BTIBR/Projeto-Eletronico/Documentos/Imagens/PS2 Controller.jpg

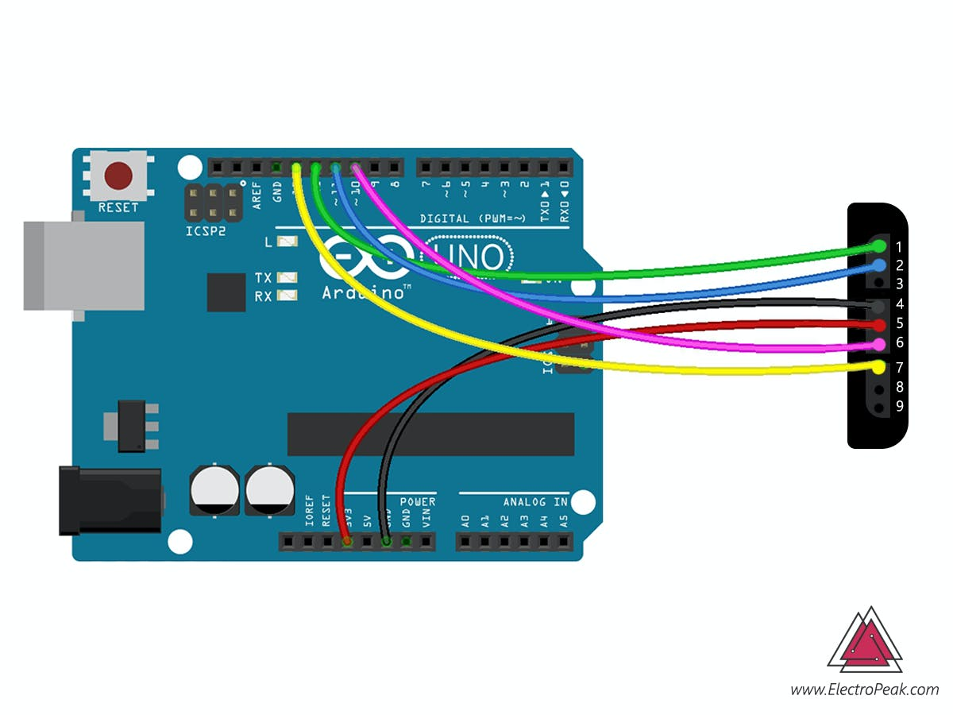
Documentos/Imagens/PS2 Controller.jpg
