BTIBR/Projeto-Eletronico/README.md

# Projeto-Eletronico

Projeto Eletrônico da PCI que contém o driver de controle dos motores de passo do Braço Robótico Leticya

### Software
- KiCad v5.1.9+
