BTIBR/Projeto-Eletronico/Datasheets/LM2596 - Buck DC-DC.PNG

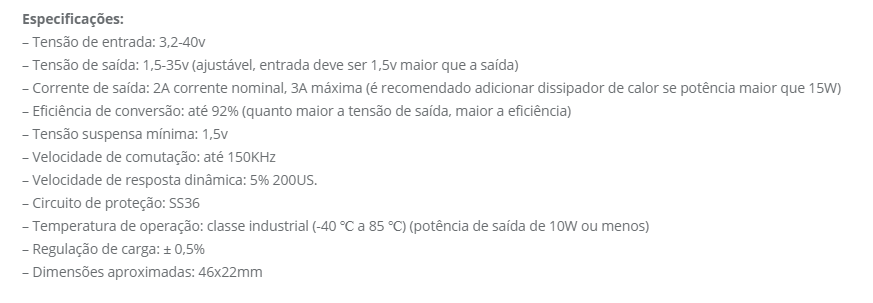
Datasheets/LM2596 - Buck DC-DC.PNG
