BTIBR/Projeto-Eletronico/Documentos/Imagens/Cabo RS485 CLP.png

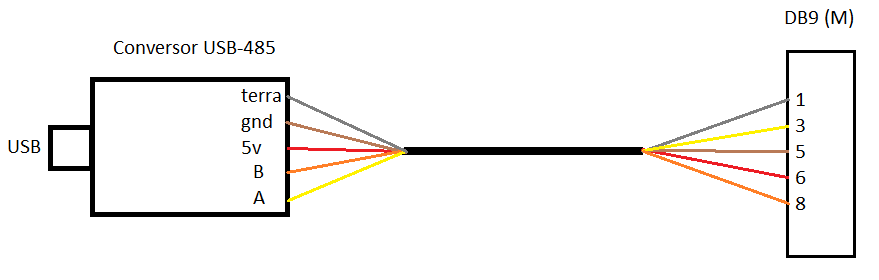
Documentos/Imagens/Cabo RS485 CLP.png
