BTIBR/Projeto-Eletronico/Documentos/Imagens/Layout PCB.png

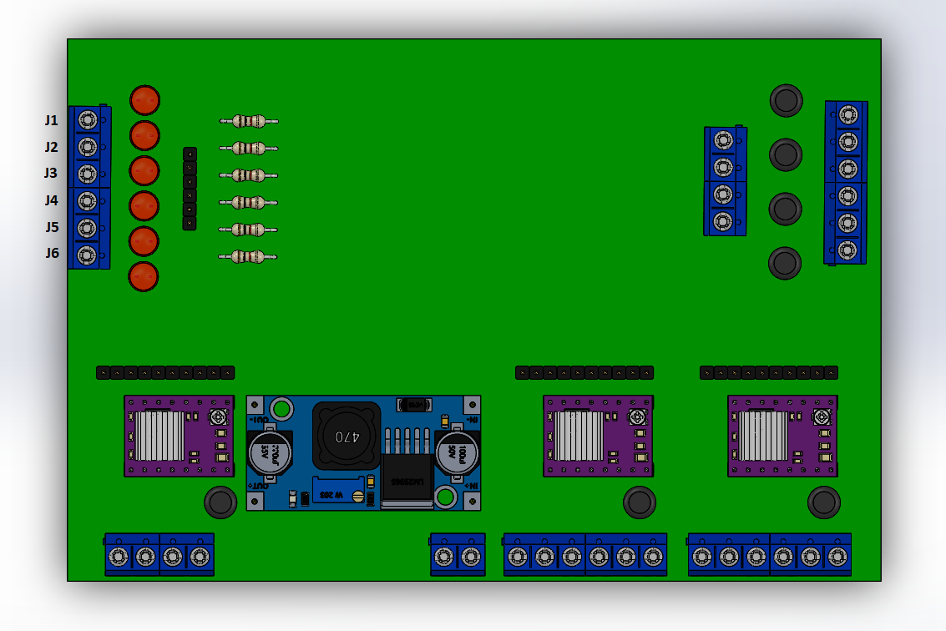
Documentos/Imagens/Layout PCB.png
