BTIBR/Projeto-Eletronico/Documentos/Imagens/Layout trilhas.png

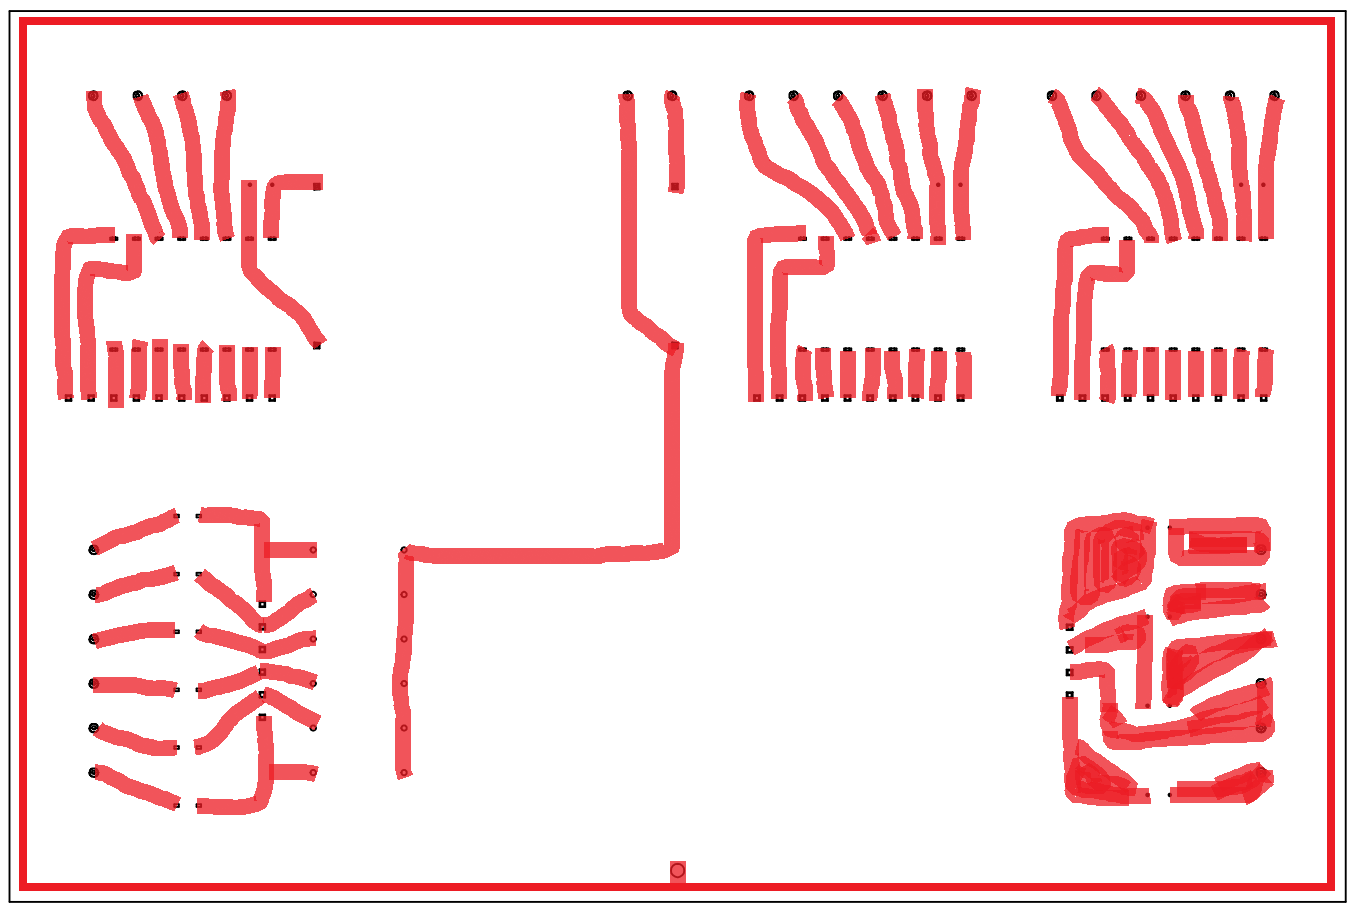
Documentos/Imagens/Layout trilhas.png
