BTIBR/Projeto-Eletronico/Documentos/Imagens/lm331 example.png

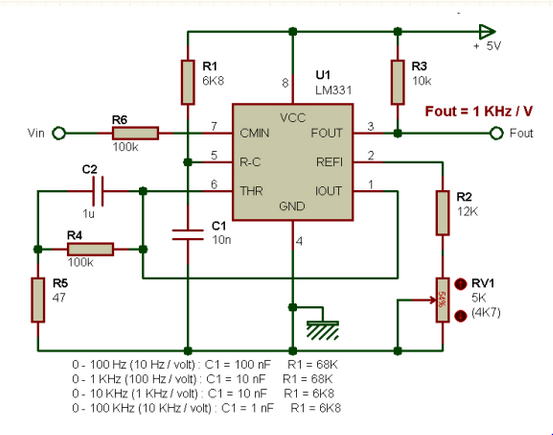
Documentos/Imagens/lm331 example.png
