BTIBR/Projeto-Eletronico/Documentos/Imagens/names.PNG

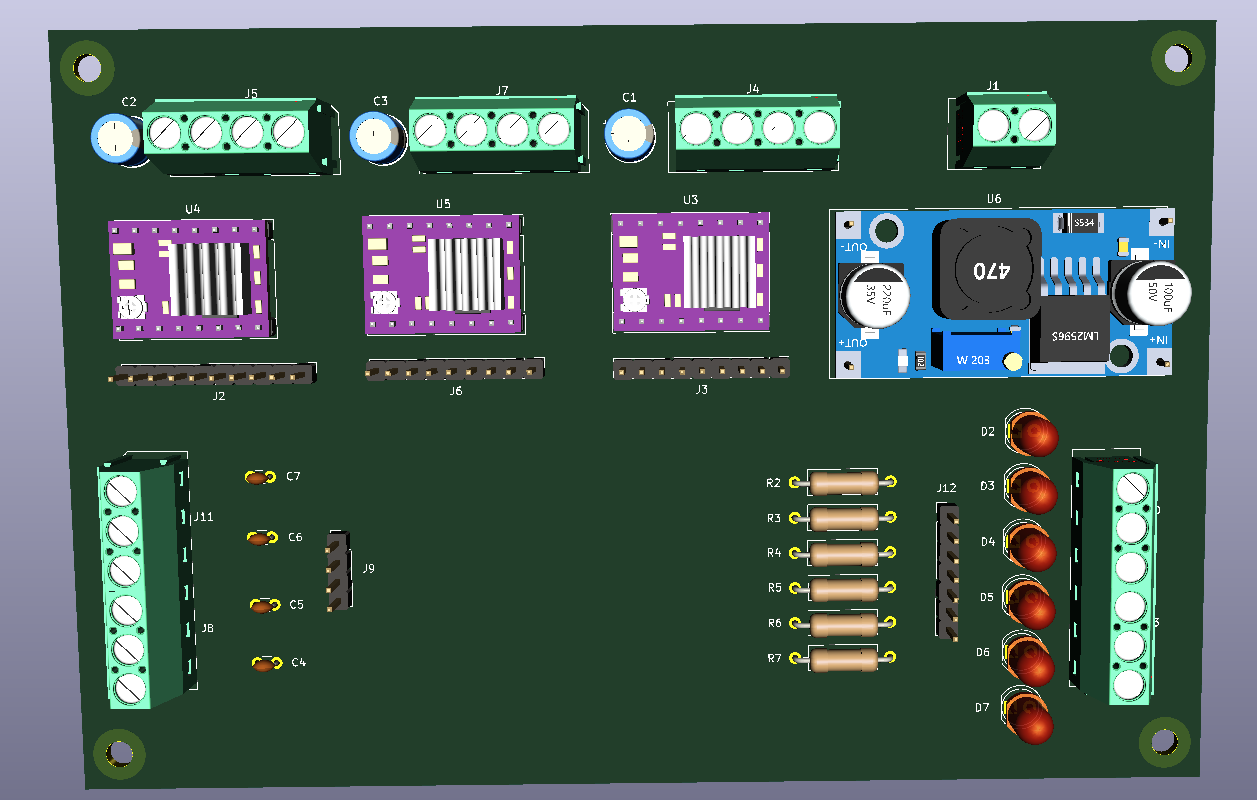
Documentos/Imagens/names.PNG
