BTIBR/Projeto-Eletronico/Documentos/Imagens/placement.PNG

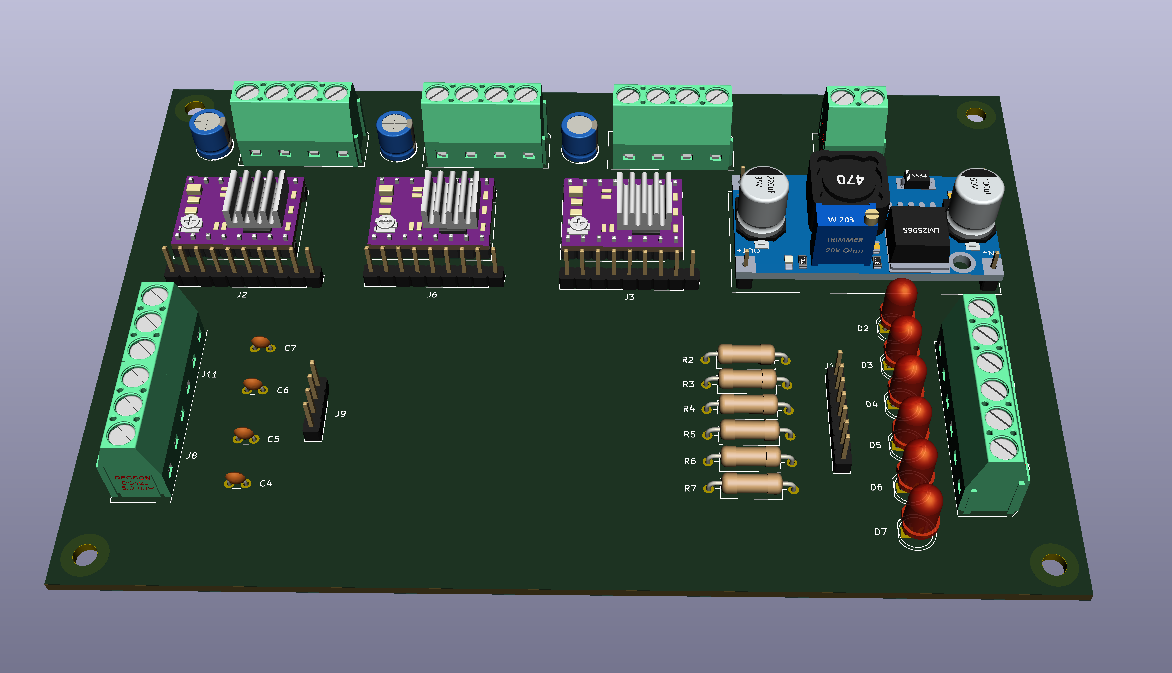
Documentos/Imagens/placement.PNG
