BTIBR/Projeto-Eletronico/Documentos/Imagens/Trilhas bcu.PNG

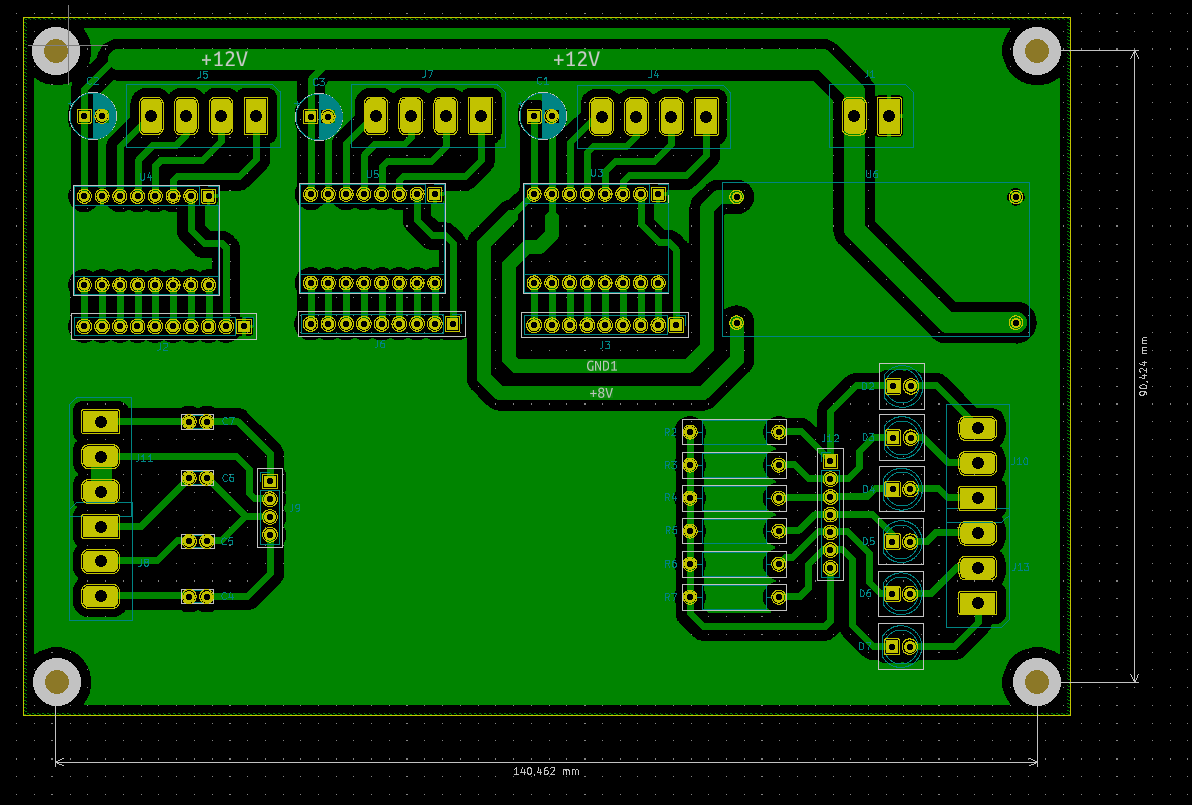
Documentos/Imagens/Trilhas bcu.PNG
