BTIBR/Projeto-Eletronico/(list of files, drawings)

Other design files:
Simulações/LM331 - Exemplo/LM331_Exemplo.pdsprj
Simulações/LM331 - Filtro PWM/LM331_Filtro_PWM.pdsprj
Simulações/LM331 - V-F 5kHz/LM331_V-F_5kHz.pdsprj
Simulações/NE555 - Gerador de Clock/NE555_Gerador_de_Clock.pdsprj
