BTIBR/Projeto-Eletronico/BTIBR_ProjetoEletronico/BTIBR-PCB-1.kicad_pcb

## KiCad design BTIBR_ProjetoEletronico/BTIBR-PCB-1.kicad_pcb (2021-10-16)

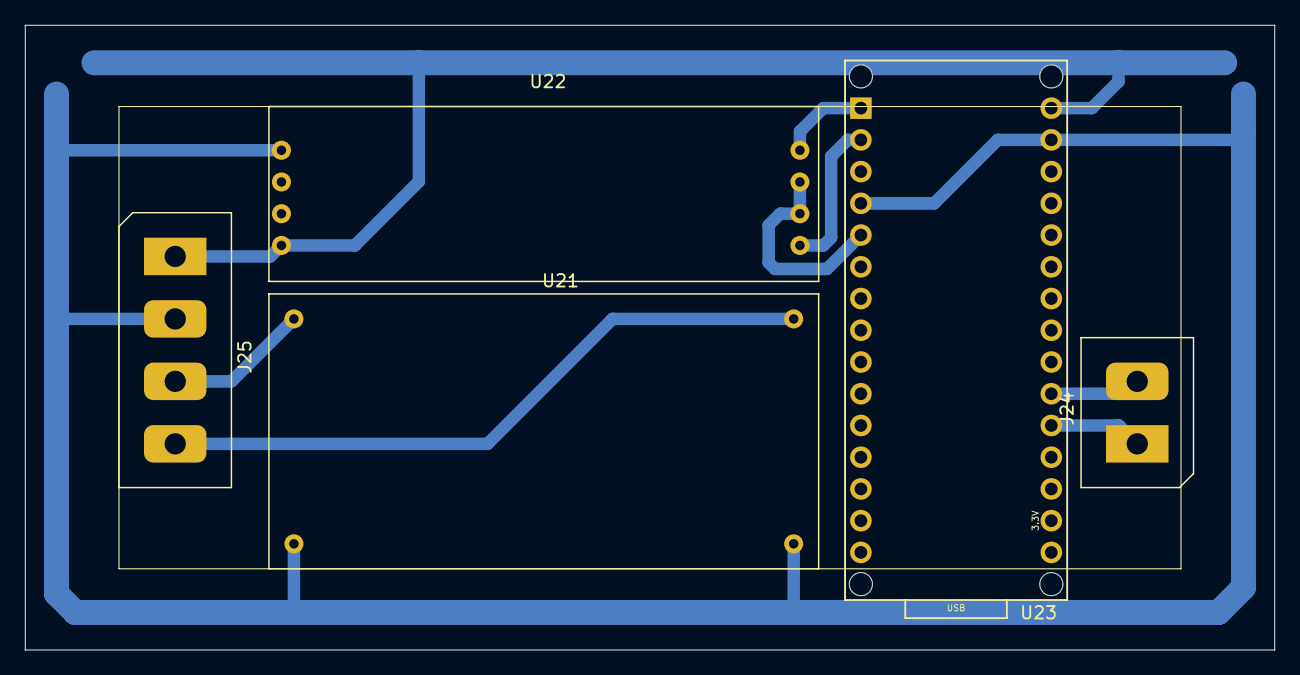
[picture p19: board BTIBR-PCB-1.kicad_pcb from above]

Board: 2 copper layers, 100.0 x 50.0 mm, 5 parts (0 on the bottom side), 9 nets.

Parts:
J24: Screw_Terminal_01x02; Connector_Screw_2pin
J25: Screw_Terminal_01x04; Connector_Screw_4pin
U21: Module_LM2596
U22: Module_MAX485
U23: Arduino_Socket_Nano

Connections:
+5V: J25.1, U22.VCC, U23.VIN
+8V: J25.4, U21.OUT+
+12V: J25.3, U21.IN+
GND: J25.2, U21.IN-, U21.OUT-, U22.GND, U23.GND1, U23.GND2
unnamed: J24.1, U23.A1
unnamed: J24.2, U23.A2
unnamed: U22.DE, U22.RE, U23.D2
unnamed: U22.DI, U23.D1
unnamed: U22.RO, U23.D0
