BTIBR/Projeto-Eletronico/BTIBR_ProjetoEletronico/BTIBR-PCB.kicad_pcb

## KiCad design BTIBR_ProjetoEletronico/BTIBR-PCB.kicad_pcb (2021-10-16)

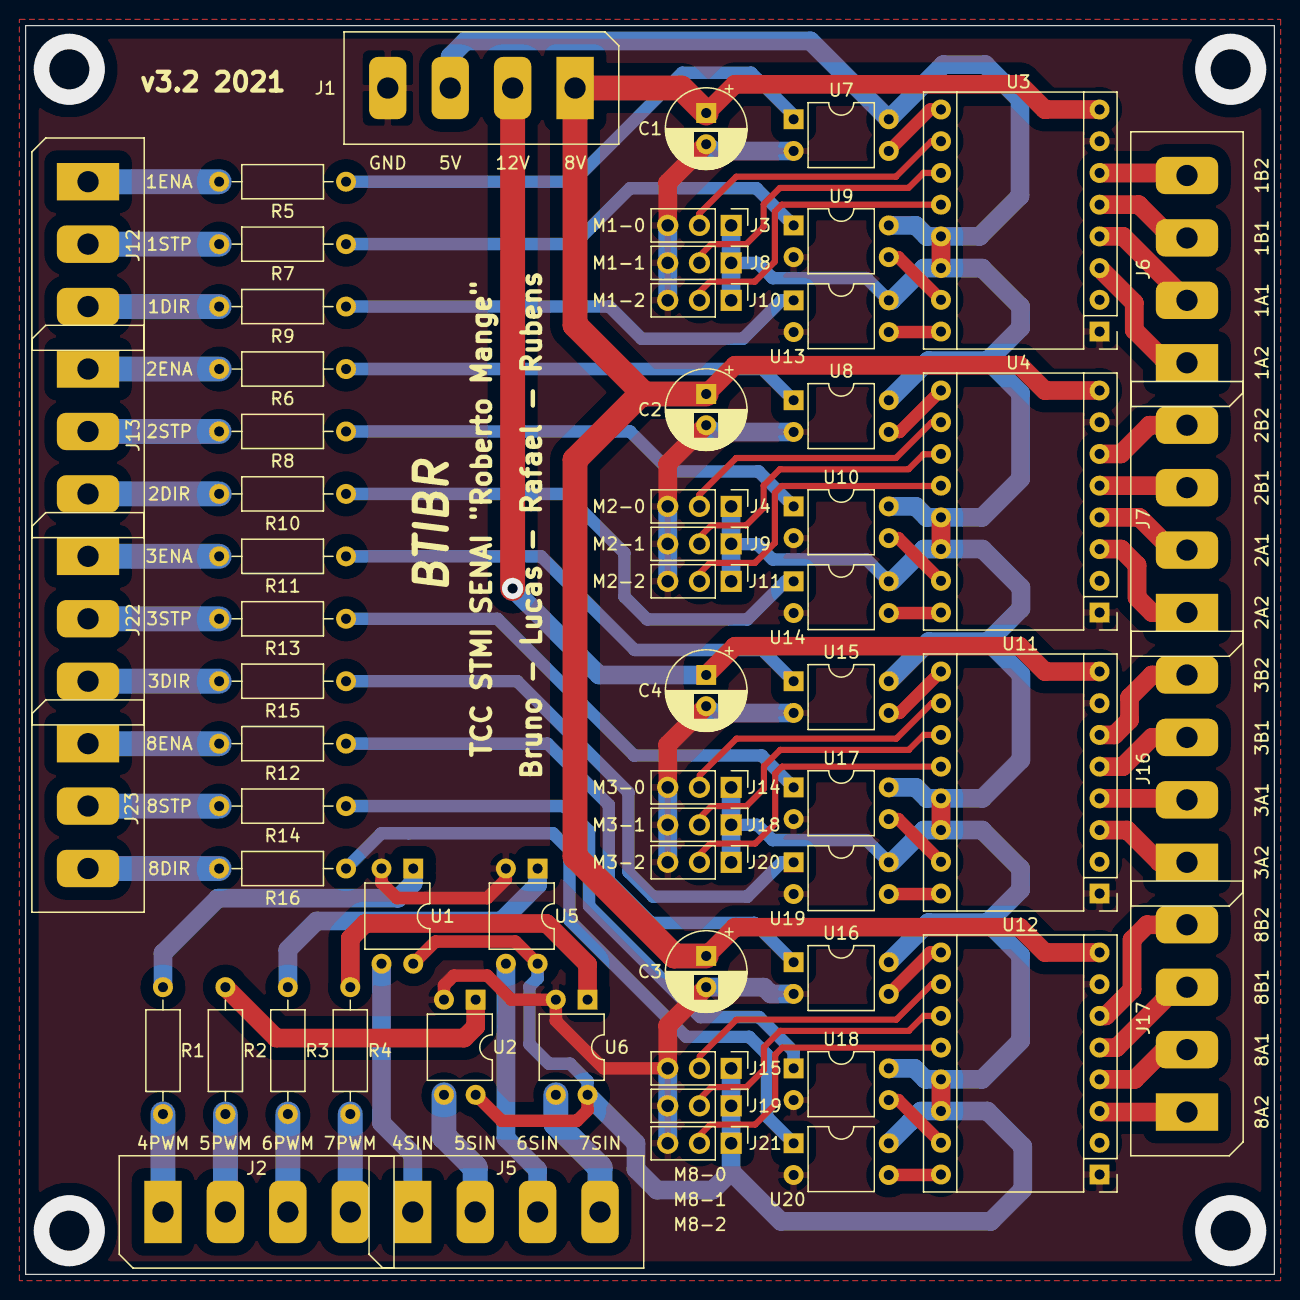
[picture p20: board BTIBR-PCB.kicad_pcb from above]

Board: 2 copper layers, 100.0 x 100.0 mm, 63 parts (0 on the bottom side), 80 nets.

Parts:
C1, C2, C3, C4: 100 μF; CP_Radial_D6.3mm_P2.50mm
J1, J2, J5, J6, J7, J16, J17: Screw_Terminal_01x04; Connector_Screw_4pin
J3, J4, J8, J9, J10, J11, J14, J15, J18, J19, J20, J21: Conn_01x03_Male; PinHeader_1x03_P2.54mm_Vertical
J12, J13, J22, J23: Screw_Terminal_01x03; Connector_Screw_3pin
R1, R2, R3, R4, R5, R6, R7, R8, R9, R10, R11, R12, R13, R14, R15, R16: 1k; R_Axial_DIN0207_L6.3mm_D2.5mm_P10.16mm_Horizontal
U1, U2, U5, U6, U7, U8, U9, U10, U13, U14, U15, U16, U17, U18, U19, U20: PC817; DIP-4_W7.62mm
U3, U4, U11, U12: DRV8825; Module_DRV8825

Connections:
+5V: J1.3, J3.1, J4.1, J8.1, J9.1, J10.1, J11.1, J14.1, J15.1, J18.1, J19.1, J20.1, J21.1, U1.4, U2.4, U3.13, U3.14, U4.13, U4.14, U5.4, U6.4, U7.4, U8.4, U9.4, U10.4, U11.13, U11.14, U12.13, U12.14, U13.4, U14.4, U15.4, U16.4, U17.4, U18.4, U19.4, U20.4
+8V: C1.1, C2.1, C3.1, J1.1, U3.8, U4.8, U12.8
+12V: C4.1, J1.2, U11.8
GND: C1.2, C2.2, C3.2, C4.2, J1.4, J3.3, J4.3, J8.3, J9.3, J10.3, J11.3, J14.3, J15.3, J18.3, J19.3, J20.3, J21.3, U1.2, U2.2, U3.1, U3.7, U4.1, U4.7, U5.2, U6.2, U7.2, U8.2, U9.2, U10.2, U11.1, U11.7, U12.1, U12.7, U13.2, U14.2, U15.2, U16.2, U17.2, U18.2, U19.2, U20.2
M1_DIR: U3.16, U13.3
M1_EN: U3.9, U7.3
M1_M0: J3.2, U3.10
M1_M1: J8.2, U3.11
M1_M2: J10.2, U3.12
M1_STEP: U3.15, U9.3
M2_DIR: U4.16, U14.3
M2_EN: U4.9, U8.3
M2_M0: J4.2, U4.10
M2_M1: J9.2, U4.11
M2_M2: J11.2, U4.12
M2_STEP: U4.15, U10.3
M3_DIR: U11.16, U19.3
M3_EN: U11.9, U15.3
M3_M0: J14.2, U11.10
M3_M1: J18.2, U11.11
M3_M2: J20.2, U11.12
M3_STEP: U11.15, U17.3
M8_DIR: U12.16, U20.3
M8_EN: U12.9, U16.3
M8_M0: J15.2, U12.10
M8_M1: J19.2, U12.11
M8_M2: J21.2, U12.12
M8_STEP: U12.15, U18.3
unnamed: J2.1, R1.2
unnamed: J2.2, R2.2
unnamed: J2.3, R3.2
unnamed: J2.4, R4.2
unnamed: J5.1, U1.3
unnamed: J5.2, U2.3
unnamed: J5.3, U5.3
unnamed: J5.4, U6.3
unnamed: J6.1, U3.3
unnamed: J6.2, U3.4
unnamed: J6.3, U3.5
unnamed: J6.4, U3.6
unnamed: J7.1, U4.3
unnamed: J7.2, U4.4
unnamed: J7.3, U4.5
unnamed: J7.4, U4.6
unnamed: J12.1, R5.2
unnamed: J12.2, R7.2
unnamed: J12.3, R9.2
unnamed: J13.1, R6.2
unnamed: J13.2, R8.2
unnamed: J13.3, R10.2
unnamed: J16.1, U11.3
unnamed: J16.2, U11.4
unnamed: J16.3, U11.5
unnamed: J16.4, U11.6
unnamed: J17.1, U12.3
unnamed: J17.2, U12.4
unnamed: J17.3, U12.5
unnamed: J17.4, U12.6
unnamed: J22.1, R11.2
unnamed: J22.2, R13.2
unnamed: J22.3, R15.2
unnamed: J23.1, R12.2
unnamed: J23.2, R14.2
unnamed: J23.3, R16.2
unnamed: R1.1, U1.1
unnamed: R2.1, U2.1
unnamed: R3.1, U5.1
unnamed: R4.1, U6.1
unnamed: R5.1, U7.1
unnamed: R6.1, U8.1
unnamed: R7.1, U9.1
unnamed: R8.1, U10.1
unnamed: R9.1, U13.1
unnamed: R10.1, U14.1
unnamed: R11.1, U15.1
unnamed: R12.1, U16.1
unnamed: R13.1, U17.1
unnamed: R14.1, U18.1
unnamed: R15.1, U19.1
unnamed: R16.1, U20.1
