BTIBR/Projeto-Eletronico/(commit log)

2021-05-19 Add backup desenvolvimento 2019-2020
    [BTIBR-Arduino.sch, BTIBR-CPU.sch, BTIBR-Fonte.sch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]
2021-05-20 Correção da estrutura de pastas
    [BTIBR-PCB-BOM_List.csv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]
2021-05-20 Correção do footprint do modulo pot digital
    [BTIBR-PCB.kicad_pcb]
2021-05-31 Adicionada BOM List customizada
    [BTIBR-PCB-BOM_List.csv, BTIBR-PCB-BOM_List_Custom.csv]
2021-06-05 Correção na resistencia Rs
2021-06-12 Correção do tipo de gráfico nas simulações
    [BTIBR-PCB.kicad_pcb]
2021-06-15 Adicionada planilha dos testes da placa
    [Teste de funcionamento da placa 20210611.xlsx]
2021-06-19 Alterada a resistencia do RV1
    [BTIBR-PCB.sch, Teste de funcionamento da placa 20210618.xlsx]
2021-07-04 Correções mínimas
    [BTIBR-Arduino.sch, BTIBR-CLP.sch, BTIBR-CPU.sch, BTIBR-Fonte.sch, BTIBR-PCB.sch, BTIBR-Robo.sch, BTIBR_ProjetoEletronico.sch]
2021-07-30 Início da versão 3 do projeto eletrônico
    [BTIBR-Arduino.sch, BTIBR-CLP.sch, BTIBR-CPU.sch, BTIBR-Fonte.sch, BTIBR-PCB.sch, BTIBR-Robo.sch, BTIBR_ProjetoEletronico.sch]
2021-07-30 Adicionada página para CLP e segunda fonte
    [BTIBR-CLP.sch, BTIBR-CPU.sch, BTIBR-Fonte-1.sch, BTIBR-Fonte-2.sch, BTIBR-PCB.sch, BTIBR-Robo.sch, BTIBR_ProjetoEletronico.sch]
2021-07-30 Adicionados barramentos das alimentações
    [BTIBR-CPU.sch, BTIBR-Robo.sch]
2021-07-31 Finalizada a versao 3.0 do esquemático
    [BTIBR-Bancada.sch, BTIBR-CLP.sch, BTIBR-Fonte-1.sch, BTIBR-Fonte-2.sch, BTIBR-PCB.sch, BTIBR-Painel.sch, BTIBR-Robo.sch, BTIBR_ProjetoEletronico.sch]
2021-07-31 Removido reglador de tensao da PCB
    [BTIBR-Fonte-1.sch, BTIBR-PCB.kicad_pcb, BTIBR-PCB.sch, BTIBR-Painel.sch]
2021-07-31 Finalizado desenvolvimento da PCB
    [BTIBR-PCB.kicad_pcb, BTIBR-PCB.sch]
2021-08-01 Gerados arquivos de fabricação (Gerber)
    [BTIBR-PCB-B_Adhes.gbr, BTIBR-PCB-B_CrtYd.gbr, BTIBR-PCB-B_Cu.gbr, BTIBR-PCB-B_Fab.gbr, BTIBR-PCB-B_Mask.gbr, BTIBR-PCB-B_Paste.gbr, BTIBR-PCB-B_SilkS.gbr, BTIBR-PCB-Cmts_User.gbr]
2021-08-01 Atualizada BOM List da placa
    [BTIBR-PCB-BOM_List_Custom.csv, Teste de funcionamento da placa 20210611.xlsx, Teste de funcionamento da placa 20210618.xlsx]
2021-09-10 Adicionado módulo da célula de carga
    [BTIBR-Bancada.sch, BTIBR-PCB.sch]
2021-09-22 Adicionados Datasheets dos Servos
2021-10-03 Adicionada célula de carga e arduino ao projeto, com comunicação RS485 com o CLP
    [BTIBR-Arduino.sch, BTIBR-Bancada.sch, BTIBR-CLP.sch, BTIBR-Fonte-1.sch, BTIBR-Fonte-2.sch, BTIBR-PCB.sch, BTIBR-Painel.sch, BTIBR-Robo.sch]
2021-10-09 Adicionada PCB-1 (Arduino, LM2596 e MAX485)
    [BTIBR-Arduino.sch, BTIBR-Bancada.sch, BTIBR-CLP.sch, BTIBR-Fonte-1.sch, BTIBR-Fonte-2.sch, BTIBR-PCB-1.kicad_pcb, BTIBR-PCB-1.sch, BTIBR-PCB.kicad_pcb]
2021-10-11 Finalizado layout da PCB-1
    [BTIBR-PCB-1.kicad_pcb, BTIBR-PCB-1.sch]
2021-10-11 Finalização da verão 3.2 do esquemático
    [BTIBR-Bancada.sch, BTIBR-CLP.sch, BTIBR-Fonte-1.sch, BTIBR-Fonte-2.sch, BTIBR-PCB-1.sch, BTIBR-PCB.sch, BTIBR-Painel.sch, BTIBR-Robo.sch]
